deved9/DE2-Solar-panel-project/img/rovnice2.png

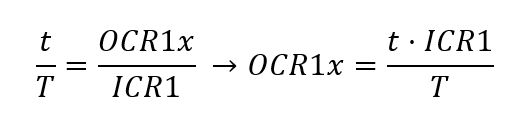
img/rovnice2.png
