deved9/DE2-Solar-panel-project/img/rovnice3.png

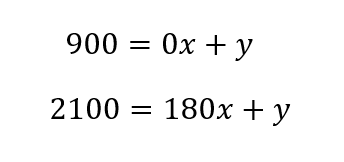
img/rovnice3.png
