deved9/DE2-Solar-panel-project/(list of files, drawings)

Other design files:
sim/komplet_schema.sim1
sim/sim2.sim1
sim/sim.sim1
