deved9/DE2-Solar-panel-project/(commit log)

2024-11-13 UART library added
2024-11-14 minor changes, Added servo library
2024-11-15 Servo lib generates PWM with 50% duty cycle
2024-11-15 PWM (uncontrollable) for 1 channel - working
2024-11-15 PWM (uncontrollable) for both channels - working
2024-11-15 Servo control through PWM completed for both servos. Testing included.
2024-11-15 SERVO library documented in README file
2024-11-15 Edited servo_test() for only min/max values of servo ranges
2024-11-16 Added analog lib + minor fixes
    [main.c, timer.h]
2024-11-16 Added interrupt handling light source tracking
2024-11-20 Added Timer2
2024-11-21 Added simulation file
    [sim.sim1]
2024-11-21 Fixed relative rotation to light. Working SimulIDE simulation included.
    [sim.sim1]
2024-11-27 Fixed interrupt problem for reading analog pins
    [sim2.sim1]
2024-12-04 Display functionality updates, TIMER2 is no more
2024-12-04 Servo and display fix
    [main.c, memory.h]
2024-12-04 added schematic for whole project
    [komplet_schema.sim1]
2024-12-06 Changed pinout from UNO to NANO, minor README fixes (servo)
2024-12-08 Added description of solar panel mount and light following algorithm to README
